fengjielab/-/-ros-/docs/learning-log.md

# 学习日志

这里按日期记录已经发生的学习、调试和整理过程。未来路线不要写成已经完成的内容，统一放在 [roadmap.md](roadmap.md)。

## 2026-08-26：建立四电机控制工程记录

### 已完成

- 建立 STM32 四电机学习历程的仓库结构。
- 整理 Git 忽略规则，排除 CubeIDE 编译产物和 workspace 文件。
- 为 `motor4_speed_monitor` 增加工程说明和测试记录入口。

### 当时的理解

- PWM 用于控制电机驱动输入的有效功率。
- 编码器用于反馈电机实际运动状态。
- 四电机控制需要分别处理 PWM 通道、方向引脚和编码器方向符号。
- FreeRTOS 任务负责组织电机控制、串口和其他周期性工作。

## 2026-08-28：梳理已有功能和硬件资料

### 已完成的功能

- 四路 PWM 输出。
- 四个电机的方向控制。
- 编码器初始化和计数。
- 基础速度计算。
- 串口启动提示或数据输出。
- FreeRTOS 任务框架。
- 基础速度闭环和 PID 调试。
- 串口调参基础功能。

### 已整理的硬件资料

- STM32F103ZET6 主控板。
- L298N 四路电机驱动模块。
- JGY-370 DC12V 10RPM 电机。
- 12V 锂电池和 DC 多路电源转换模块。
- 两版麦克纳姆轮、打印车架、接线图和演示视频。

### 本次遇到的重要问题

电机单独调试时的安装方向与最终安装到车架后的方向不同，导致代码中的电机方向和编码器方向不能直接沿用。详细过程记录在[调试与问题记录](../motor4_speed_monitor/debuge和问题记录.md)中。

### 当前仍需补充

- PWM 频率、定时器时钟、计数周期和占空比的准确数值。
- 每个电机的目标速度、实际速度和误差。
- 最终车体装配后的 PID 参数及调参过程。
- 串口调参的命令格式和参数范围。

### 本阶段结论

底层四电机控制已经具备继续推进的基础。下一阶段先按照 [后续路线图](roadmap.md) 补齐运动学、通信和 ROS 之间的依赖关系，再逐步实现上层功能。
