fengjielab/-/-ros-/motor4_speed_monitor/问题排查日记.md

# 问题排查日记

> **记录时间**：2026年8月29日
> **项目**：motor4_speed_monitor（STM32F103ZET6 · 四电机测速监控）
> **目的**：记录从"给板子上电"到"四个电机转起来 + PID闭环"的完整学习排查过程

---

## 目录

- [问题1：给板子上电是什么意思，板子里面进行了什么动作](#问题1给板子上电是什么意思板子里面进行了什么动作)
- [问题2：main.c 第57行的 0.1f 是什么意思](#问题2mainc-第57行的-01f-是什么意思)
- [问题3：电机转起来只要 GPIO 一高一低就行了吗](#问题3电机转起来只要-gpio-一高一低就行了吗)
- [问题4：驱动芯片上的使能接口是 PWM 通讯吗](#问题4驱动芯片上的使能接口是-pwm-通讯吗)
- [问题5：一次调四个电机是复制四份代码吗](#问题5一次调四个电机是复制四份代码吗)
- [问题6：定时器在这里面的三个作用](#问题6定时器在这里面的三个作用)
- [问题7：定时器为什么能"数"编码器脉冲](#问题7定时器为什么能数编码器脉冲)
- [问题8：从硬件角度，四个电机转起来的代码一一对应](#问题8从硬件角度四个电机转起来的代码一一对应)
- [问题9：HAL_TIM_Encoder_Start 是我们定义的吗，参数怎么确定](#问题9hal_tim_encoder_start-是我们定义的吗参数怎么确定)
- [问题10：同一定时器不同通道 vs 不同定时器；吐方波谁控制](#问题10同一定时器不同通道-vs-不同定时器吐方波谁控制)
- [问题11：switch 是干啥的；闭环少了什么背景；编码器计数从哪来](#问题11switch-是干啥的闭环少了什么背景编码器计数从哪来)
- [问题12：`} PID_t;` 这种写法为什么奇怪](#问题12pid_t-这种写法为什么奇怪)
- [问题13：第186行函数声明是干啥的](#问题13第186行函数声明是干啥的)
- [问题14：指针是什么，为什么这么表示，内部有什么](#问题14指针是什么为什么这么表示内部有什么)
- [问题15：PID 在哪里定义、在哪里应用](#问题15pid-在哪里定义在哪里应用)
- [问题16：PID 算法详解 + 指针数值实例](#问题16pid-算法详解--指针数值实例)
- [问题17：`->` 箭头是啥意思，举例](#问题17--箭头是啥意思举例)
- [问题18：main 之前各种定义的区别](#问题18main-之前各种定义的区别)
- [问题19：让四个电机转起来的完整总结](#问题19让四个电机转起来的完整总结)
- [问题20：真正需要自己写的是哪些，其余是什么](#问题20真正需要自己写的是哪些其余是什么)

---

## 问题1：给板子上电是什么意思，板子里面进行了什么动作

**上电 = 供电 + 芯片复位 + CPU 从 Flash 启动 + 执行烧录的程序。**

1. **硬件层**：5V/USB 电源输入 → 稳压芯片输出 3.3V → 复位电路让 NRST 先低后高（等电源稳定）。
2. **芯片层**：复位释放 → CPU 从 Flash `0x08000000` 读向量表（初始SP + Reset_Handler）→ 启动文件复制 .data、清零 .bss → 调用 `SystemInit()` → 跳转 `main()`。
3. **本项目的 main() 顺序**（main.c 210 行起）：
   - `HAL_Init()`：复位外设、开 SysTick
   - `SystemClock_Config()`：HSE 8MHz × PLL9 → **72MHz**
   - `MX_GPIO_Init()`：PG0~PG7 配输出、初始全 0（电机不转）
   - `MX_TIM1~4_Init()`：编码器接口；`MX_TIM8/MX_TIM5_Init()`：PWM；`MX_TIM6_Init()`：100ms 定时
   - `MX_USART1_UART_Init()`：串口 115200
   - 启动编码器 → 启动 PWM → **先设 PWM=0（防乱转）** → 设正转方向 → 给 `BASE_PWM=300` → **电机转起来**
   - 之后 `while(1)` 里每 100ms 由 TIM6 中断触发一次 PID 闭环

---

## 问题2：main.c 第57行的 0.1f 是什么意思

```c
/* 控制周期 = 100ms */
#define CONTROL_DT        0.1f
```

- `0.1` = 0.1 秒 = 100ms（控制周期）
- `f` 后缀 = float 单精度浮点，避免按 double 处理
- 用途（单位统一为"秒"）：
  - **积分项**：`pid->integral += error * CONTROL_DT;`（乘法）
  - **微分项**：`derivative = (error - pid->last_error) / CONTROL_DT;`（除法）

---

## 问题3：电机转起来只要 GPIO 一高一低就行了吗

**不完全是，方向对了一半。**

- ✅ **方向确实靠"一高一低"**：`Motor_Forward()` 把驱动芯片 IN1/IN2 设为一高一低 → H桥输出一正一负 → 正转。
- ❌ **缺速度控制**：GPIO 只有 0/1 两种电平，只能"全速/停"，不能调速。调速必须用 **PWM**（占空比→平均电压→转速），由 `Motor_SetPWM()` 写定时器比较寄存器实现。
- ❌ **电机不能直连 GPIO**：GPIO 电流太小（~20mA），电机要几百 mA~几 A，中间必须有**驱动芯片（H桥）**。GPIO 只控制驱动芯片的逻辑脚。

一个电机 = **方向线（GPIO，IN1/IN2）+ 调速线（PWM）** 两根控制线。

---

## 问题4：驱动芯片上的使能接口是 PWM 通讯吗

**方向正确，措辞要修正。**

- ✅ 驱动芯片确实有使能/调速脚（EN / ENA/ENB / PWM），项目里 PC6/PC7/PC8/PA0 就是连这四根线。
- ❌ **PWM 不是"通讯"**：不是 UART/I2C 那种数据协议，没有数据包/波特率。PWM 就是一根快速高低切换的方波，靠**占空比**决定平均电压。
- ⚠️ **"使能"和"调速"通常合并在一根线上**：占空比 0% = 关断，100% = 全速，中间值 = 半速。
- 代码：`HAL_TIM_PWM_Start()`（开启方波）+ `__HAL_TIM_SET_COMPARE()`（设占空比），波形本身由定时器硬件自动翻转产生。

---

## 问题5：一次调四个电机是复制四份代码吗

**不是无脑复制，分两类：**

- **绑定硬件的初始化**（必须复制四份，躲不掉）：`MX_TIM1~4_Init()`、编码器启动、PWM 启动、`Motor_Forward(1~4)`——因为 TIM1~TIM4 是不同的物理外设。
- **核心控制逻辑**（一套代码搞定四路）：
  - **数组一人一格**：`motor_count[4]`、`motor_pwm[4]`、`PID_t motor_pid[4]`
  - **编号参数 + switch 分派**：`Motor_SetPWM(uint8_t motor, ...)` 按 motor=1/2/3/4 分发到不同定时器通道
  - **for 循环**：`for(i=0;i<4;i++){ motor_pwm[i]=PID_Update(&motor_pid[i],...); Motor_SetPWM(i+1, motor_pwm[i]); }`

> 以后想四个电机各转各的速度，把 `target_count` 从单个 float 改成 `float target[4]` 即可。

---

## 问题6：定时器在这里面的三个作用

项目中 6 个定时器分三组：

| 定时器 | 模式 | 作用 |
|---|---|---|
| **TIM6** | 基础定时器（中断） | **心跳**：每 100ms 一次中断，提醒"该测速控制了" |
| **TIM8 / TIM5** | PWM 输出 | **手**：硬件自动吐方波到驱动芯片 EN 脚，占空比=转速 |
| **TIM1~TIM4** | 编码器模式 | **眼睛**：硬件自动数编码器脉冲（感知转速） |

**三者配合成闭环**：眼睛(TIM1~4 读数) → 心跳(TIM6 提醒) → CPU 算 PID → 手(TIM8/TIM5 改占空比) → 电机 → 眼睛继续数。

---

## 问题7：定时器为什么能"数"编码器脉冲

**因为编码器模式定时器 = 一个纯硬件脉冲计数器，不需要 CPU 参与。**

- 编码器装电机轴上，转过一格输出一个脉冲（A/B 两相）。
- 定时器把引脚边沿**当成时钟**：来一个边沿，计数器 CNT 自动 +1 或 -1（TIM_ENCODERMODE_TI12 同时看 A/B 相，还能根据相位差自动判方向）。
- CPU 只做三件事：**启动**（`HAL_TIM_Encoder_Start`）、**读总数**（`__HAL_TIM_GET_COUNTER`）、**清零**（`__HAL_TIM_SET_COUNTER`），每 100ms 一次。
- 为什么不能让 CPU 数：脉冲频率高（4 电机 × 每秒上千个），CPU 会被中断淹没、丢脉冲、没时间算 PID。

> 类比：CPU 是老板，定时器是门口自动计数器，老板只定期来看一眼总数再归零。

---

## 问题8：从硬件角度，四个电机转起来的代码一一对应

**硬件地图**：

| 电机 | 方向IN1 | 方向IN2 | 调速PWM | 编码器A/B | 编码器定时器 |
|---|---|---|---|---|---|
| M1 | PG0 | PG1 | PC6(TIM8_CH1) | PA15/PB3 | TIM2 |
| M2 | PG2 | PG3 | PC7(TIM8_CH2) | PA6/PA7 | TIM3 |
| M3 | PG4 | PG5 | PC8(TIM8_CH3) | PB6/PB7 | TIM4 |
| M4 | PG6 | PG7 | PA0(TIM5_CH1) | PE9/PE11 | TIM1 |

**代码四步**：
1. 初始化：`MX_GPIO_Init()`（方向脚）+ `MX_TIM*_Init()`（PWM/编码器/定时器）
2. 启动：编码器 `HAL_TIM_Encoder_Start` ×4、PWM `HAL_TIM_PWM_Start` ×4、计数器清零
3. 安全：`Motor_SetPWM(1~4, 0)` 先全停
4. 转动：`Motor_Forward(1~4)` 定方向 + `Motor_SetPWM(1~4, BASE_PWM)` 给速度
5. 闭环：TIM6 中断读编码器 → 主循环 PID → 改占空比

---

## 问题9：HAL_TIM_Encoder_Start 是我们定义的吗，参数怎么确定

**不是我们定义的，是 ST 官方 HAL 库函数。**

- 定义在 `Drivers/STM32F1xx_HAL_Driver/Src/stm32f1xx_hal_tim.c`（第 3213 行）。
- 函数内部真正干活的是：`TIM_CCxChannelCmd()`（写 CCER 寄存器开通道）+ `__HAL_TIM_ENABLE()`（写 CR1 寄存器 CEN 位启动计数）。
- **参数① `&htim2`**：`htim2` 是 CubeMX 生成的句柄结构体（tim.c 第 28 行 `TIM_HandleTypeDef htim2;`），由 `MX_TIM2_Init()` 填充（Instance、Prescaler、Period、EncoderMode 等）。传地址 = "告诉函数操作哪个定时器"。
- **参数② `TIM_CHANNEL_ALL`**：库头文件预定义宏，值 `0x0000003C`（stm32f1xx_hal_tim.h 第 742 行）。编码器必须同时开 CH1+CH2（A/B 两相），所以用 ALL。

> 查任何 HAL 函数参数的方法：打开对应头文件搜宏定义，看函数上方注释的参数说明。

---

## 问题10：同一定时器不同通道 vs 不同定时器；吐方波谁控制

**通道 vs 定时器**：
- **同一个定时器的不同通道**：共享一个计数器 CNT 和一个周期 ARR → **频率必须一样，但占空比各自独立**（各通道有自己的 CCR）。如 TIM8_CH1/2/3 → M1/M2/M3，共享 1kHz、占空比分别调。
- **不同定时器**：完全独立，频率、模式都可以不同。如 TIM8(PWM) vs TIM2(编码器)。

**吐方波谁控制**：
- **CubeMX 不参与运行时**！它只是开发时的代码生成工具，烧录后就"不存在"了。
- **波形产生 = 板子硬件电路自动控制**（定时器计数器自动翻转引脚，CPU 不参与）。
- **占空比数值 = 代码写寄存器控制**（`__HAL_TIM_SET_COMPARE`）。

> 记忆：CubeMX=设计师（提前画图）、代码=操作员（按开关/调旋钮）、定时器硬件=机器（自动吐方波）。

---

## 问题11：switch 是干啥的；闭环少了什么背景；编码器计数从哪来

**① switch 是"多选一"分支语句**（`Motor_SetPWM` 用）：

```c
switch (motor) {
    case 1: __HAL_TIM_SET_COMPARE(&htim8, CH1, pwm); break;  // =1 → M1
    case 2: __HAL_TIM_SET_COMPARE(&htim8, CH2, pwm); break;  // =2 → M2
    ...
}
```

本质：把"同一个动作"按编号分发到不同硬件（不同定时器通道/不同 GPIO 引脚）。

**② 闭环不缺环节，缺"标定背景"**：
闭环 5 环节（目标→误差→PID→执行器→传感器）代码里全有。缺的是两个还没标定的参数：
- `target_count = 150` 暂时没有物理意义（注释：先写 50/150 是示例）
- `ENCODER_CPR = 1` 是临时的，每圈真实脉冲数要手动转一圈测出来再填

**③ 编码器计数不是目标值**：
- `motor_count[]` = **实际**数到的脉冲，来自**电机真实转动**产生的编码器脉冲，由定时器硬件自动数，代码只是每 100ms 读一次
- `target_count` = **期望**值，是代码写死的
- PID 就是让"目标 150"和"实测值"不断互相逼近

---

## 问题12：`} PID_t;` 这种写法为什么奇怪

这是 C 语言 **typedef 定义结构体**的标准写法：

```c
typedef struct { ... } PID_t;
```

- `typedef` = 给这个结构体类型**起别名**
- 好处：以后声明变量直接写 `PID_t motor_pid[4];`，不用每次带 `struct` 关键字
- `_t` 后缀 = type（类型）的约定惯例
- 对比：没有 typedef 就得写 `struct PID {...};` 然后 `struct PID motor_pid[4];`

> 结构体把"系数(kp/ki/kd)"和"状态(integral/last_error)"打包，让每个电机带一份独立 PID 记忆。

---

## 问题13：第186行函数声明是干啥的

```c
float PID_Update(PID_t *pid, float target, float actual);   // 声明：只有签名+分号
...
float PID_Update(PID_t *pid, float target, float actual) {  // 定义：带函数体，在517行
    ...
}
```

- **声明** = 提前告诉编译器"这个函数存在"，这样靠前的 `main()`（210行）才能调用靠后定义的函数（517行）。
- C 编译器从上往下编译，没有声明会报"未定义"。
- 三个参数：`&motor_pid[i]`（哪个电机的PID，指针以便修改状态）、`target_count`（目标）、`motor_count[i]`（实际）。
- 顺带发现：代码里有两处重复的 `/* USER CODE BEGIN PFP */` 和 `Motor_SetPWM` 声明（181/182行、184/195行），是工具多次插入留下的，无害但冗余。

---

## 问题14：指针是什么，为什么这么表示，内部有什么

**指针 = 一个装"别人地址"的变量。**

- **内部是什么**：一个 32 位数字（内存地址）。STM32F1 是 32 位 MCU，地址范围 `0x00000000~0xFFFFFFFF`，所以存地址的变量占 4 字节。
- **为什么叫指针**：它"指"着另一个变量的家。类比：门牌号小纸条，不用搬整栋房子，拿纸条就能找到并修改。
- **为什么这么表示**：

```c
PID_t *pid     // 类型 + 星号 + 名字 = "指向PID_t的指针"
```

- **三个配套符号**：
  - `&motor_pid[0]`：取地址（拿门牌号）
  - `pid->integral`：按地址访问成员（箭头）
  - `*pid`：解引用（按门牌号取出整个结构体）

- **为什么 PID 必须用指针**：
  1. 函数要**修改原始数据**（integral/last_error），传副本改了没用
  2. 省内存：PID_t 20字节 vs 指针4字节

---

## 问题15：PID 在哪里定义、在哪里应用

**PID 不是单个函数，是"类型 + 实例 + 算法 + 调用点 + 开关"的总和，共 5 处：**

| 角色 | 位置 | 内容 |
|---|---|---|
| ① 定义类型 | main.c 109~118 行 | `typedef struct {...} PID_t;`（造模具，不占内存） |
| ② 创建实例 | main.c 131~137 行 | `PID_t motor_pid[4] = {...};`（4个盒子，M1~M4各一，kp=7 ki=1 kd=0） |
| ③ 声明算法 | main.c 186~188 行 | `float PID_Update(...);`（预告） |
| ④ 实现算法 | main.c 517~592 行 | `float PID_Update(...){...}`（真正的 PID 算法） |
| ⑤ 调用应用 | main.c 348~362 行 | 主循环 `for(i...) PID_Update(&motor_pid[i],...)` → `Motor_SetPWM` |

另有开关 `#define PID_ENABLE 1`（144行）控制 342 行 `#if PID_ENABLE`：1=闭环，0=开环（PWM 固定 300）。

---

## 问题16：PID 算法详解 + 指针数值实例

**PID_Update 六步**（main.c 517~592 行）：

```c
error      = target - actual;                    // 1. 误差 = 目标 - 实际
pid->integral += error * CONTROL_DT;             // 2. 积分（累加历史误差），限幅±100
derivative = (error - pid->last_error) / CONTROL_DT;  // 3. 微分（误差变化速度）
correction = pid->kp*error + pid->ki*pid->integral
           + pid->kd*derivative;                 // 4. 三项加权
pid->last_error = error;                         // 5. 记住本次误差
output     = BASE_PWM + correction;              // 6. 基础300 + 修正，限幅0~700
return output;
```

**数值实例**（target=150，kp=7，ki=1，kd=0，BASE_PWM=300）：

| 轮次 | 实际 | error | integral | correction | output | 盒子更新 |
|---|---|---|---|---|---|---|
| 第1轮 | 100(慢) | 50 | 0→5 | 7×50+1×5=355 | **655**（加速） | integral=5, last_error=50 |
| 第2轮 | 150(达标) | 0 | 5→5 | 7×0+1×5=5 | **305**（维持） | integral=5, last_error=0 |
| 第3轮 | 155(超了) | -5 | 5→4.5 | 7×(-5)+1×4.5=-30.5 | **269.5**（减速） | integral=4.5, last_error=-5 |

**指针的作用**：`pid->integral` 改的是 main 里 `motor_pid[i]` 的原始内存，所以每次调用后积分/上次误差能"记住"（跨 100ms 保留）。若传值副本，积分永远清零，PID 只剩 P 项在抖。

---

## 问题17：`->` 箭头是啥意思，举例

**箭头运算符 = 通过指针访问结构体成员**，是 `(*指针).成员` 的简写。

```c
pid->integral   ≡   (*pid).integral
```

**三个符号对比**：

| 符号 | 什么时候用 | 例子 |
|---|---|---|
| `.` | 手上有盒子本身（结构体变量） | `motor_pid[0].kp` |
| `&` | 拿盒子的门牌号 | `&motor_pid[0]` |
| `->` | 手上只有门牌号（指针） | `pid->integral` |

**内存实例**（假设 motor_pid[0] 住在 0x20000000）：

```
0x20000000 → 7.0  = motor_pid[0].kp
0x20000004 → 1.0  = motor_pid[0].ki
0x20000008 → 0.0  = motor_pid[0].kd
0x2000000C → 5.0  = motor_pid[0].integral
0x20000010 → -3.0 = motor_pid[0].last_error
```

执行 `pid->integral += 5;` = "顺着门牌号 0x20000000 找到盒子，把 0x2000000C 格子从 5.0 改成 10.0"。main 里再读 `motor_pid[0].integral` 就是 10.0（同一个格子）。

> 为什么函数里全用 `->`？因为函数里只有指针 `pid`，没有 `motor_pid` 这个名字；有盒子用点，只有门牌号用箭头。

---

## 问题18：main 之前各种定义的区别

main 之前共有 **6 种性质不同的东西**：

| 种类 | 标志 | 占内存? | 什么时候存在 | 项目实例 |
|---|---|---|---|---|
| 头文件包含 | `#include` | 不占 | 编译时展开 | `#include "main.h"` |
| 宏定义 | `#define` | 不占 | 编译前文本替换后消失 | `#define BASE_PWM 300` |
| 全局变量 | `类型 名 = 初值;` | **占 RAM** | 上电后一直在 | `float target_count = 150.0f;` |
| 类型定义 | `typedef struct {...} 名;` | 不占（模具） | 编译期被理解 | `typedef struct {...} PID_t;` |
| 函数声明 | `返回 名(参数);` | 不占 | 只有签名 | `float PID_Update(...);` |
| 函数定义 | `返回 名(参数){...}` | **占 Flash** | 上电后指令可执行 | `float PID_Update(...){...}` |

- **宏 vs 变量**：宏是编译前文本替换（`PWM_MAX`→`700`），不占内存；变量是真实内存格子。
- **声明 vs 定义**：声明只打招呼（不分配），定义才分配。
- **类型 vs 变量**：typedef 是模具，变量是产品。
- 另外还有 `extern`（在 stm32f1xx_it.c 里 `extern TIM_HandleTypeDef htim6;`）：只引用别的文件定义的变量。

> 记忆：只有**变量占 RAM、函数定义占 Flash**，其余几种编译后基本消失。

---

## 问题19：让四个电机转起来的完整总结

```
① 初始化外设（只做一次）
   HAL_Init → SystemClock_Config(72MHz) → MX_GPIO/TIM1~6/TIM8/TIM5/USART1_Init
② 打通外设（main.c 250~273）
   启动4个编码器计数 + 清零 + 启动4路PWM
③ 安全先停（main.c 281~284）
   Motor_SetPWM(1~4, 0)
④ 定方向（main.c 291~294）
   Motor_Forward(1~4) → IN1=1/IN2=0 → 正转
⑤ 给速度（main.c 322~325）
   Motor_SetPWM(1~4, BASE_PWM=300) → 占空比30% → 电机转起来 ✅
⑥ 每100ms闭环（TIM6中断 + 主循环）
   读编码器 → PID算新PWM → 下发 → 逼近target_count=150
```

| 步骤 | 硬件效果 | 代码位置 |
|---|---|---|
| 初始化 | 引脚/外设各就各位 | `MX_XXX_Init()` |
| 打通外设 | 计数器开始数、引脚开始吐方波 | main.c 250~273 |
| 先全停 | 电机不动（安全） | main.c 281~284 |
| 定方向 | H桥一正一负 → 正转 | `Motor_Forward()` |
| 给速度 | 30%占空比 → 中速转 | `Motor_SetPWM()` |
| 闭环 | 自动调速逼近目标 | TIM6中断+主循环PID |

---

## 问题20：真正需要自己写的是哪些，其余是什么

**工程分三层**：

| 层 | 谁生成 | 要不要动 |
|---|---|---|
| ① USER CODE 区域 | **自己写** | ✅ 所有工作在这 |
| ② 板级初始化（gpio/tim/usart/main骨架） | CubeMX 生成 | ❌ 改了会被重新生成覆盖 |
| ③ HAL 驱动库（Drivers/） | ST 官方 | ❌ 永远不用碰 |

**真正要自己写的 = main.c 里所有 `/* USER CODE BEGIN */` 之间的代码**，共 6 个区块：

- `USER CODE BEGIN Includes`：`#include <stdio.h>` 等
- `USER CODE BEGIN PV`：控制参数（BASE_PWM/PWM_MAX/CONTROL_DT）、`target_count`、`motor_count[4]`、`PID_t` 结构体、`motor_pid[4]`
- `USER CODE BEGIN PFP`：自定义函数声明
- `USER CODE BEGIN 2`：启动编码器/PWM、设方向、给 PWM（main 里的初始化）
- `USER CODE BEGIN 3`：`while(1)` 里的 PID 闭环
- `USER CODE BEGIN 4`：函数实现（Motor_SetPWM / PID_Update / Motor_Forward / Send_Control_Data / HAL_TIM_PeriodElapsedCallback）

**CubeMX 的作用**：开发时用 `.ioc` 图形界面配引脚/外设 → 生成模板代码；烧录后完全不参与运行。

> 以后改东西永远在 USER CODE 区域里改，CubeMX 重新生成不会覆盖它们。

---

## 附：关键代码位置速查表（main.c）

| 内容 | 行号 |
|---|---|
| 控制参数宏 | 56~77 |
| 编码器计数数组 motor_count | 84~89 |
| PWM 数组 motor_pwm | 96~102 |
| PID 结构体定义 | 109~118 |
| PID 实例 motor_pid[4] | 131~137 |
| PID_ENABLE 开关 | 144 |
| 编码器测速参数 | 156~175 |
| 函数原型声明 | 179~199 |
| main() | 210 |
| 启动编码器/PWM/方向/PWM | 250~325 |
| 主循环 PID 调用 | 348~385 |
| 串口数据发送 | 434~470 |
| Motor_SetPWM（switch 分派） | 478~516 |
| PID_Update（PID 算法） | 517~592 |
| Motor_Forward（方向） | 598~648 |
| TIM6 中断回调（读编码器） | 672~727 |

---

*本文档由学习排查过程整理而成，覆盖：上电流程、GPIO 方向控制、PWM 调速、编码器测速、定时器分工、HAL 库与 CubeMX 分工、switch 分发、PID 闭环、指针与结构体、C 语言各类定义。*
