fengjielab/-/-ros-/图片层/成型的打印连接件安装.jpg

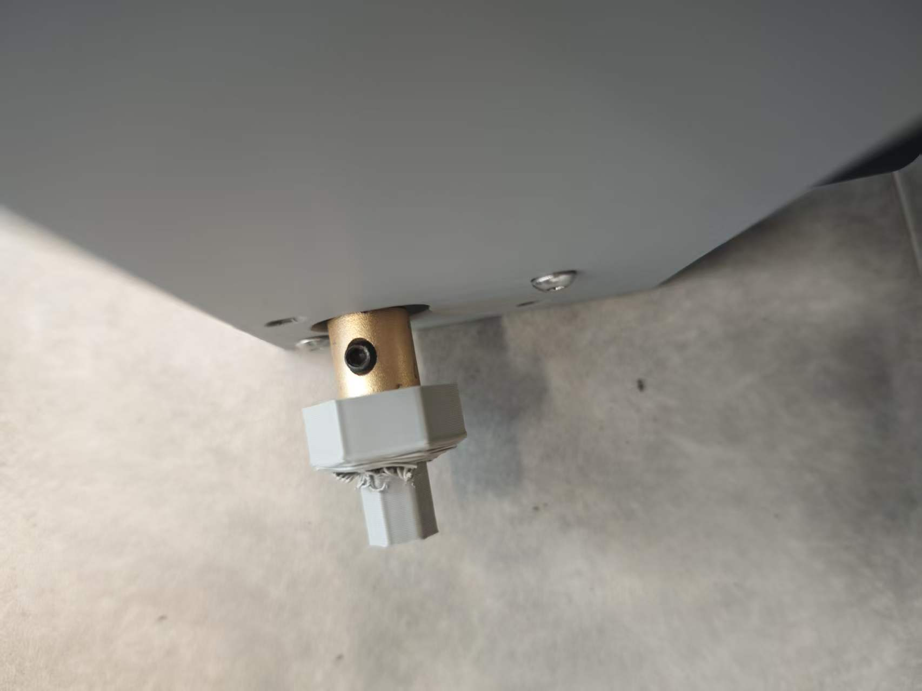
-ros-/图片层/成型的打印连接件安装.jpg
