fengjielab/-/-ros-/图片层/打印的麦克纳姆与轴的连接件.jpg

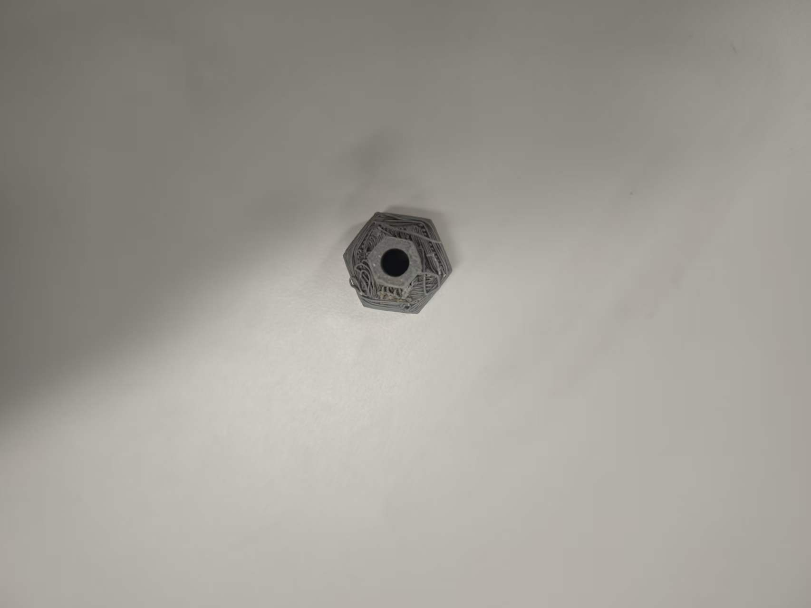
-ros-/图片层/打印的麦克纳姆与轴的连接件.jpg
