fengjielab/-/-ros-/motor4_speed_monitor/debuge和问题记录.md

# 调试与问题记录

这里记录调试过程中出现的现象、原因、排查过程、处理方式和可以迁移到后续项目的经验。

## 2026-08-28：电机安装后方向与 PID 参数需要重新确认

### 背景

最初调试时，四个电机没有安装到最终车架上，只是分别让电机运行并进行基础 PID 调试。

### 现象

电机安装到车架后，发现实际机械方向与单独调试时的方向定义不同。原来代码中的电机方向和编码器方向不能直接照搬，继续使用会导致控制方向与实际运动方向相反。

### 原因

电机本体的正反转定义，和电机安装到车架后的轮子实际运动方向不是同一个概念。最终方向由电机接线、驱动器输入、编码器接线以及电机在车架上的安装方向共同决定。

### 排查与处理

1. 将每个电机安装到最终车架位置。
2. 单独测试每个电机的 PWM 和方向控制。
3. 对照轮子的实际运动方向，逐个核对代码中的方向定义。
4. 根据最终机械结构调整电机方向和编码器方向符号。
5. 重新确认 PID 参数是否仍然适用于安装后的负载和机械结构。

### 经验

电机没有安装到最终机械结构之前调通的参数，只能作为初始值。方向、编码器符号和 PID 参数必须在最终车体装配完成后重新验证。

## 后续问题记录模板

```markdown
## 日期：问题标题

### 现象

### 原因

### 排查过程

### 解决方法

### 验证结果

### 经验
```
