fengjielab/-/-ros-/图片层/学习历程图片管理/8.28麦克轮正负/串口调试图.png

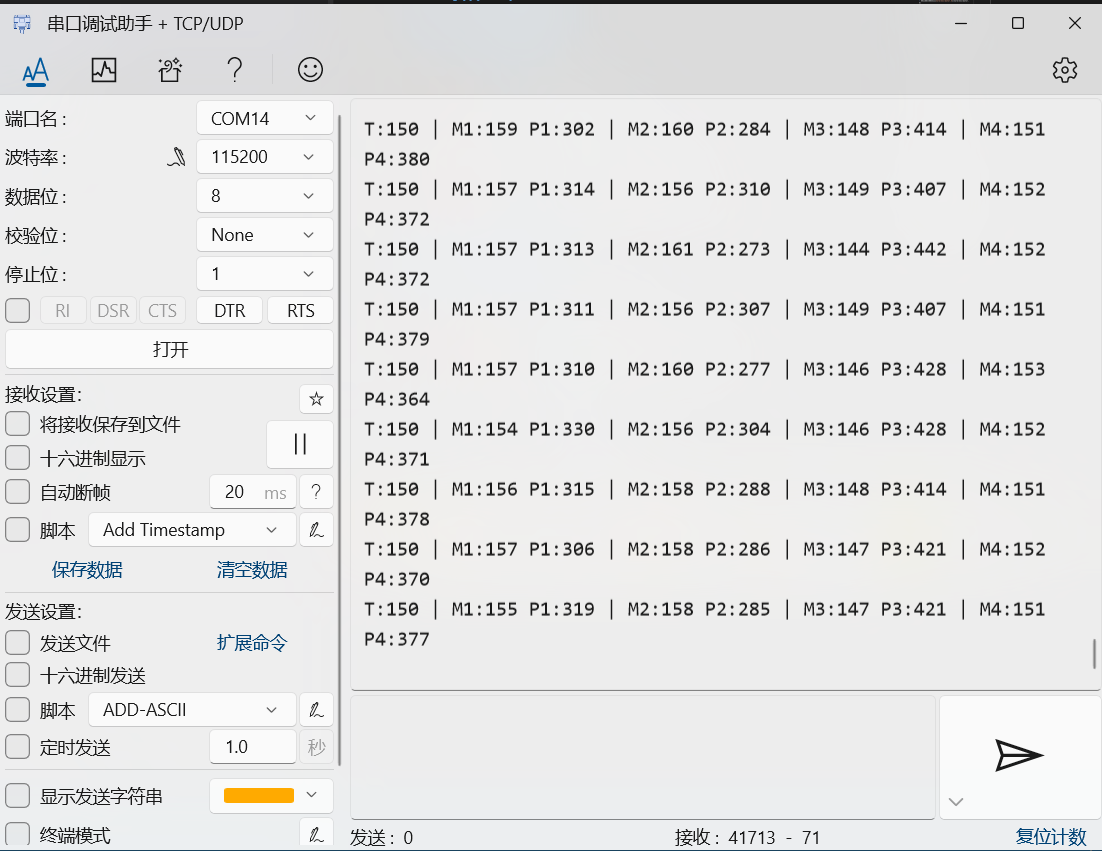
-ros-/图片层/学习历程图片管理/8.28麦克轮正负/串口调试图.png
