fengjielab/-/-ros-/motor4_speed_monitor/Core/Src/main.c

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
/* Includes ------------------------------------------------------------------*/
#include "main.h"
#include "cmsis_os.h"
#include "tim.h"
#include "usart.h"
#include "gpio.h"

/* USER CODE BEGIN Includes */
#include<stdio.h>
#include<stdlib.h>
#include "motor.h"
/* USER CODE END Includes */


/* USER CODE BEGIN PV */
/* USER CODE BEGIN PV */


/* =========================================
 * 控制参数
 * ========================================= */

/* 控制周期 = 100ms */


/* USER CODE END PV */

void SystemClock_Config(void);
void MX_FREERTOS_Init(void);
/* USER CODE BEGIN PFP */
/* USER CODE BEGIN PFP */


void Send_Control_Data(void);

/* USER CODE END PFP */

/**
  * @brief  The application entry point.
  * @retval int
  */
int main(void)
{

  /* MCU Configuration--------------------------------------------------------*/

  /* Reset of all peripherals, Initializes the Flash interface and the Systick. */
  HAL_Init();

  /* Configure the system clock */
  SystemClock_Config();

  /* Initialize all configured peripherals */
  MX_GPIO_Init();
  MX_TIM1_Init();
  MX_TIM2_Init();
  MX_TIM3_Init();
  MX_TIM4_Init();
  MX_TIM6_Init();
  MX_TIM8_Init();
  MX_USART1_UART_Init();
  MX_TIM5_Init();
  /* USER CODE BEGIN 2 */
  /* USER CODE BEGIN 2 */

  /* =========================
     1. 启动四个编码器
     ========================= */

   Motor_Init();


  /* =========================
     6. 启动100ms测速中断
     =========================

  HAL_TIM_Base_Start_IT(&htim6);
  */

  /* =========================
     7. 给电脑发一句启动提示
     ========================= */

  char start_msg[] = "\r\nMotor speed monitor started!\r\n";

  HAL_UART_Transmit(&huart1,
                    (uint8_t *)start_msg,
                    sizeof(start_msg) - 1,
                    100);


  /* =========================
     8. 暂时先让四台电机30% PWM
     ARR = 999
     所以300约等于30%
     ========================= */


  /* USER CODE END 2 */

  /* Init scheduler */
  osKernelInitialize();  /* Call init function for freertos objects (in cmsis_os2.c) */
  MX_FREERTOS_Init();

  /* Start scheduler */
  osKernelStart();

  /* We should never get here as control is now taken by the scheduler */

  /* Infinite loop */
  /* USER CODE BEGIN WHILE */
  while (1)
  {
    /* USER CODE END WHILE */

    /* USER CODE BEGIN 3 */
	  /* USER CODE BEGIN 3 */



  }
  /* USER CODE END 3 */
}

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
/* USER CODE BEGIN 4 */
/* USER CODE BEGIN 4 */

/* ============================================================
   电机PWM控制
   pwm范围：0 ~ 999
   ============================================================ */




/* ============================================================
   TIM6每100ms调用一次

   做的事情：

   1. 读取四个编码器
   2. 保存100ms内计数
   3. 把计数器重新清零
   4. 告诉main()：有新数据了
   ============================================================ */


/* USER CODE END 4 */

/**
  * @brief  Period elapsed callback in non blocking mode
  * @note   This function is called  when TIM7 interrupt took place, inside
  * HAL_TIM_IRQHandler(). It makes a direct call to HAL_IncTick() to increment
  * a global variable "uwTick" used as application time base.
  * @param  htim : TIM handle
  * @retval None
  */
void HAL_TIM_PeriodElapsedCallback(TIM_HandleTypeDef *htim)
{
  if (htim->Instance == TIM7)
  {
    HAL_IncTick();
  }
}

/**
  * @brief  This function is executed in case of error occurrence.
  * @retval None
  */
void Error_Handler(void)
{
  /* USER CODE BEGIN Error_Handler_Debug */
  /* User can add his own implementation to report the HAL error return state */
  __disable_irq();
  while (1)
  {
  }
  /* USER CODE END Error_Handler_Debug */
}
#ifdef USE_FULL_ASSERT
/**
  * @brief  Reports the name of the source file and the source line number
  *         where the assert_param error has occurred.
  * @param  file: pointer to the source file name
  * @param  line: assert_param error line source number
  * @retval None
  */
void assert_failed(uint8_t *file, uint32_t line)
{
  /* USER CODE BEGIN 6 */
  /* User can add his own implementation to report the file name and line number,
     ex: printf("Wrong parameters value: file %s on line %d\r\n", file, line) */
  /* USER CODE END 6 */
}
#endif /* USE_FULL_ASSERT */
