fengjielab/-/-ros-/motor4_speed_monitor/motor4_speed_monitor.ioc

Mcu.UserName=STM32F103ZETx
PA0-WKUP.Signal=S_TIM5_CH1
PA10.Signal=USART1_RX
PA13.Signal=SYS_JTMS-SWDIO
PA14.Signal=SYS_JTCK-SWCLK
PA15.Signal=S_TIM2_CH1_ETR
PA6.Signal=S_TIM3_CH1
PA7.Signal=S_TIM3_CH2
PA9.Signal=USART1_TX
PB3.Signal=S_TIM2_CH2
PB6.Signal=S_TIM4_CH1
PB7.Signal=S_TIM4_CH2
PC14-OSC32_IN.Signal=RCC_OSC32_IN
PC15-OSC32_OUT.Signal=RCC_OSC32_OUT
PC6.GPIO_Label=M1_PWM
PC6.Signal=S_TIM8_CH1
PC7.GPIO_Label=M2_PWM
PC7.Signal=S_TIM8_CH2
PC8.GPIO_Label=M3_PWM
PC8.Signal=S_TIM8_CH3
PE11.Signal=S_TIM1_CH2
PE9.Signal=S_TIM1_CH1
PG0.GPIO_Label=M1_IN1
PG0.Signal=GPIO_Output
PG1.GPIO_Label=M1_IN2
PG1.Signal=GPIO_Output
PG2.GPIO_Label=M2_IN1
PG2.Signal=GPIO_Output
PG3.GPIO_Label=M2_IN2
PG3.Signal=GPIO_Output
PG4.GPIO_Label=M3_IN1
PG4.Signal=GPIO_Output
PG5.GPIO_Label=M3_IN2
PG5.Signal=GPIO_Output
PG6.GPIO_Label=M4_IN1
PG6.Signal=GPIO_Output
PG7.GPIO_Label=M4_IN2
PG7.Signal=GPIO_Output
