fengjielab/-/-ros-/motor4_speed_monitor/Core/Inc/main.h

#define M1_IN1_Pin GPIO_PIN_0
#define M1_IN1_GPIO_Port GPIOG
#define M1_IN2_Pin GPIO_PIN_1
#define M1_IN2_GPIO_Port GPIOG
#define M2_IN1_Pin GPIO_PIN_2
#define M2_IN1_GPIO_Port GPIOG
#define M2_IN2_Pin GPIO_PIN_3
#define M2_IN2_GPIO_Port GPIOG
#define M3_IN1_Pin GPIO_PIN_4
#define M3_IN1_GPIO_Port GPIOG
#define M3_IN2_Pin GPIO_PIN_5
#define M3_IN2_GPIO_Port GPIOG
#define M4_IN1_Pin GPIO_PIN_6
#define M4_IN1_GPIO_Port GPIOG
#define M4_IN2_Pin GPIO_PIN_7
#define M4_IN2_GPIO_Port GPIOG
#define M1_PWM_Pin GPIO_PIN_6
#define M1_PWM_GPIO_Port GPIOC
#define M2_PWM_Pin GPIO_PIN_7
#define M2_PWM_GPIO_Port GPIOC
#define M3_PWM_Pin GPIO_PIN_8
#define M3_PWM_GPIO_Port GPIOC
