fengjielab/-/(commit log)

2026-09-07 增加了电脑端键盘直接控制nano以及esp32的ardiuno代码
2026-09-07 更新git命令，更新esp32串口使用错误问题,增加了调试命令行
2026-09-07 增加了nano和esp的通信
2026-09-10 git的学习
2026-09-10 ros总结
2026-09-10 代理配置问题
2026-09-16 修改两个系统之间的差异
2026-09-17 增加了速度转化公式和部分接口
2026-09-17 把里面的计时系统还有之前的150计数器换成了m/s
2026-09-17 更改了ros节点内容，换成速度联控
2026-09-17 速度连续化控制记录
